nachomcapella/3D-printed-elbow-and-forearm-orthosis/documentacion/images/modelo-3d-6-2.JPG

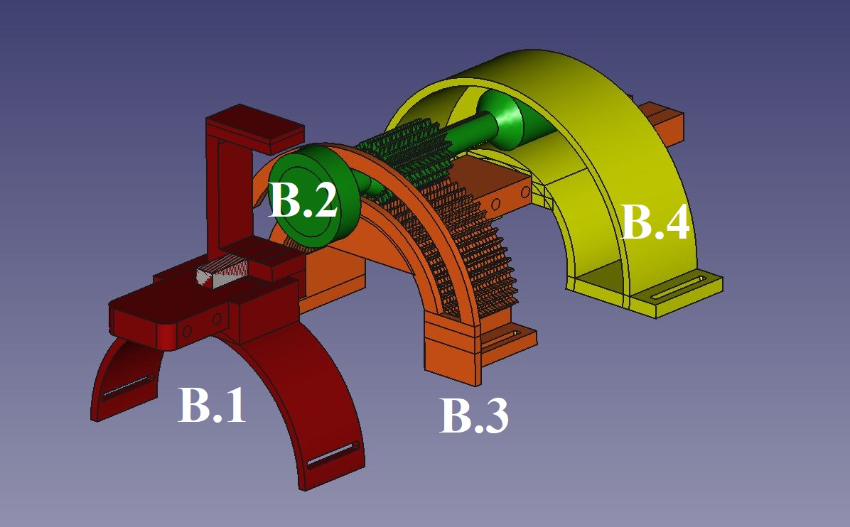
documentacion/images/modelo-3d-6-2.JPG
