nachomcapella/3D-printed-elbow-and-forearm-orthosis/documentacion/documents/presentacion-proyectos-3.pptx

## Design, development and control of a robotic arm

Proyectos III – Ignacio Martínez Capella

## Index

- Introduction
- 3D design
- Electronic components
- Results
- Conclusions

## Introduction - Orthoses

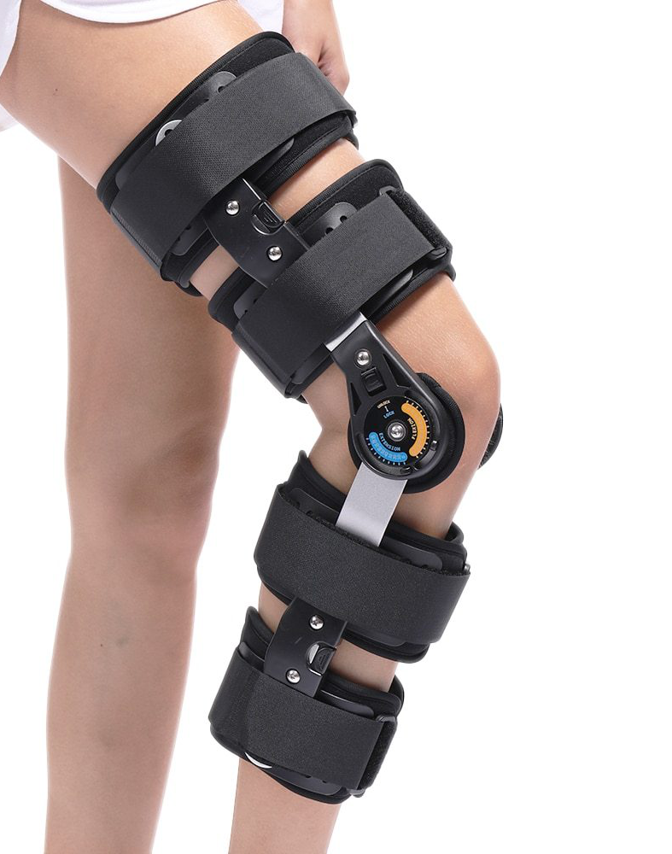
[picture p8: figure]

- What is an orthosis?
  - A medical device used to modify the functional and structural characteristics of the neuromuscular and skeletal system of the patient.
- Four types:
  - Supportive
  - Dynamic
  - Corrective
  - Protective
- Increasing demand
- 3D printers

## Introduction – Our model

- Based on a previous orthosis developed in the master’s degree
- 3D printed
- Flexion/extension of the arm
- New movements: pronation/supination of the forearm

## 3D design

- FreeCAD
- Witbox 3D printer, PLA filaments
- Two main pieces:
  - A: arm
  - B: forearm

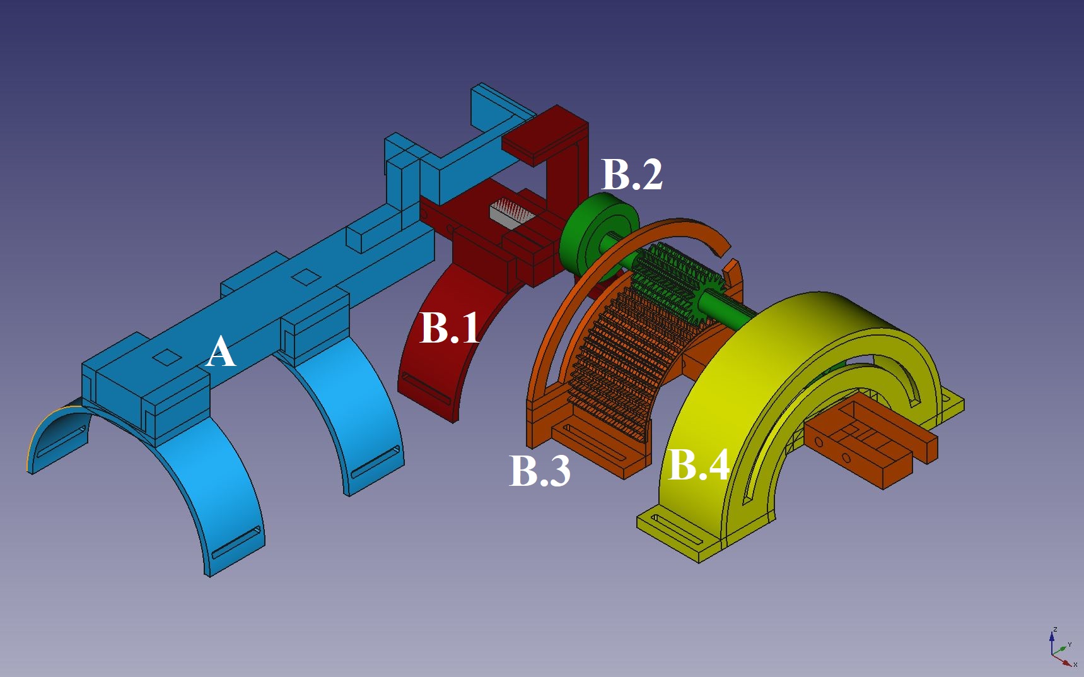
[picture p9: figure]

## 3D design

- FreeCAD
- Witbox 3D printer, PLA filaments
- Two main pieces:
  - A: arm
  - B: forearm


## Electronic components

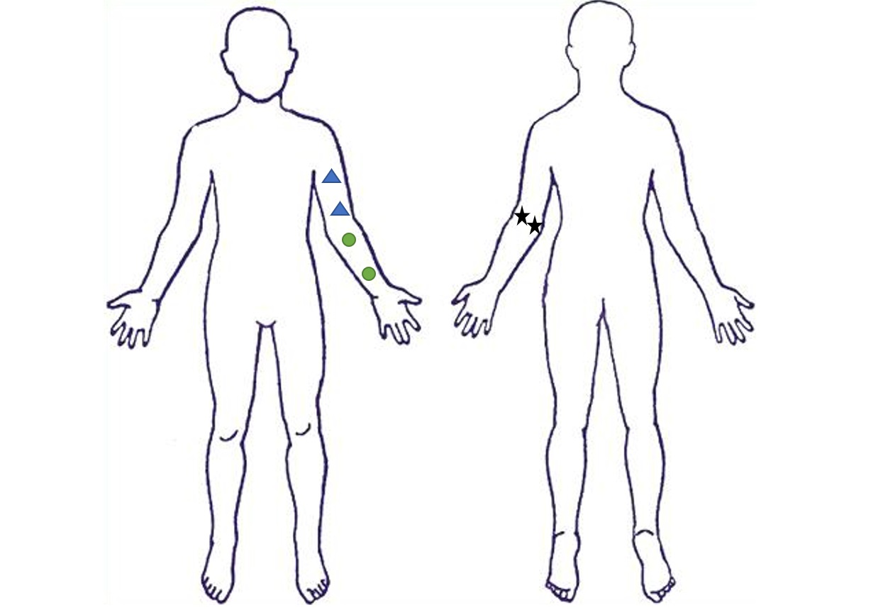
[picture p10: figure]

- A: EMG audio Jack
- B: Instrumentation amplifier
- C: Arduino Micro
- D: RG gain resistor
  - G=(5∗10^4)/(R_G)+1
- E: Servomotor

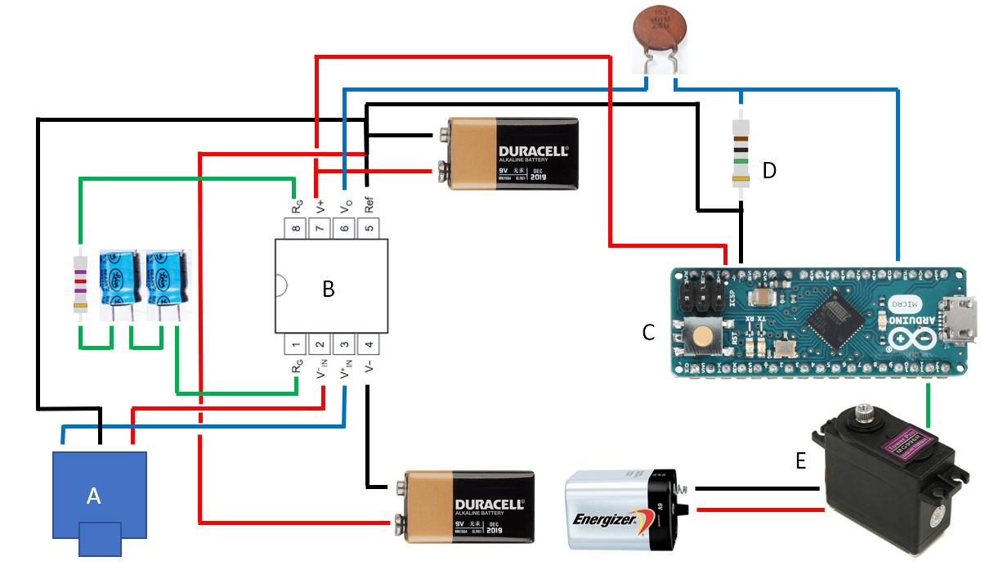
[picture p11: figure]

## Electronic components

- Voluntary contraction: Intended contraction of a muscle group
- Involuntary contraction: Passive contraction of a muscle group when another one is voluntarily contracted
  - Forearm: 5 voluntary + 5 involuntary contractions
  - Biceps: 5 voluntary + 5 involuntary contractions

Signal | Top 25 values mean
Voluntary forearm | 180.6
Involuntary forearm | 63.28
Voluntary biceps | 386.16
Involuntary biceps | 265

## Results

## Conclusions

- Objective achieved
- Future work
