nachomcapella/3D-printed-elbow-and-forearm-orthosis/documentacion/images/diagrama-emg-amplificador.pptx

## EMG Amplifier Diagram

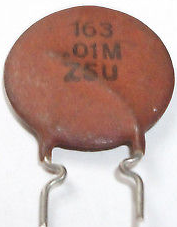
[picture p12: figure]
Resultado de imagen de bc z5u 103m
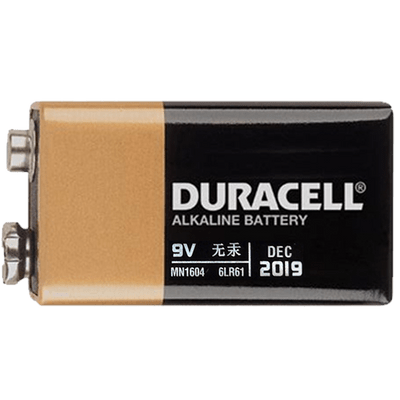
[picture p13: figure]
Resultado de imagen de 9v battery png

50K/R + 1

D

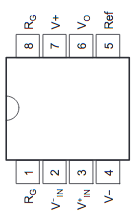
[picture p14: figure]
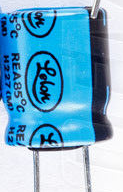
[picture p15: figure]
Resultado de imagen de rea85 35V

B

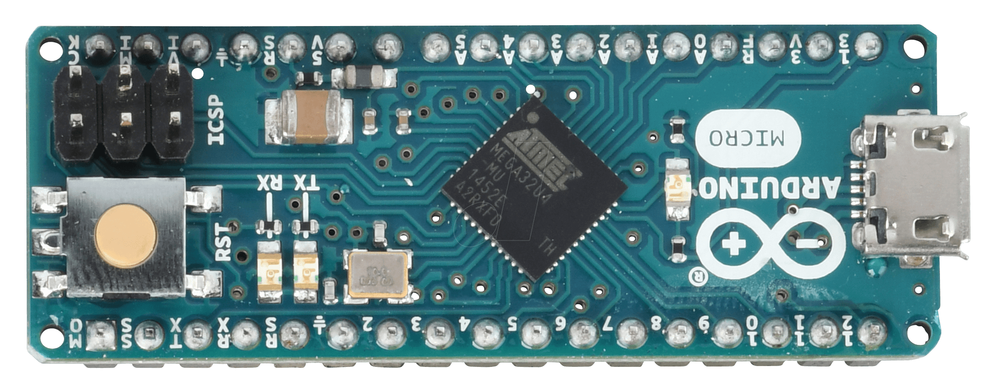
[picture p16: figure]
Resultado de imagen de arduino micro

C

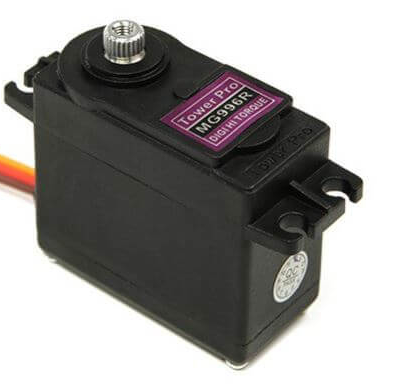
[picture p17: figure]

A

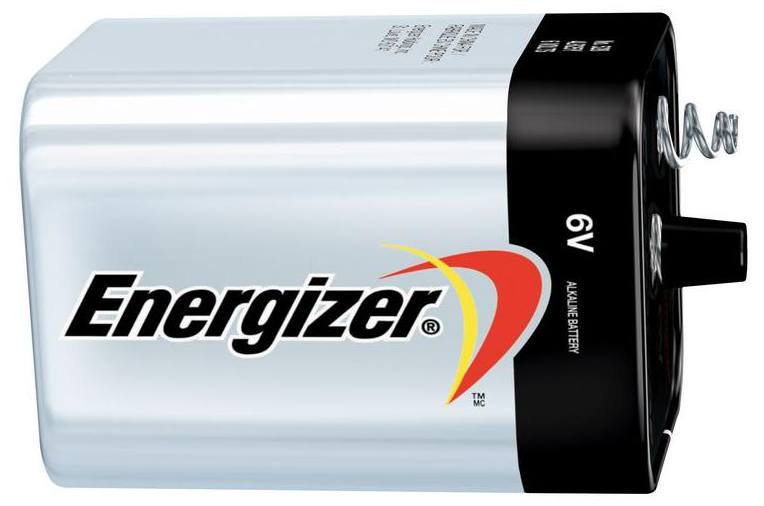
[picture p18: figure]

E
