nachomcapella/3D-printed-elbow-and-forearm-orthosis/documentacion/images/modelo-3d-5.JPG

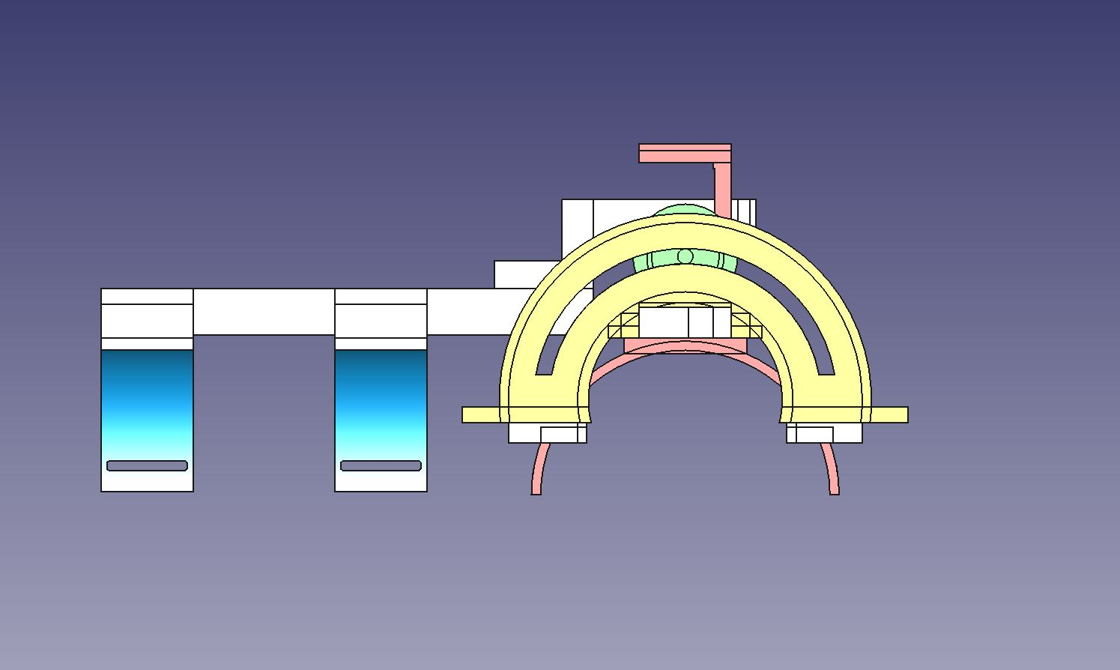
documentacion/images/modelo-3d-5.JPG
