nachomcapella/3D-printed-elbow-and-forearm-orthosis/documentacion/images/orthosis-final.JPG

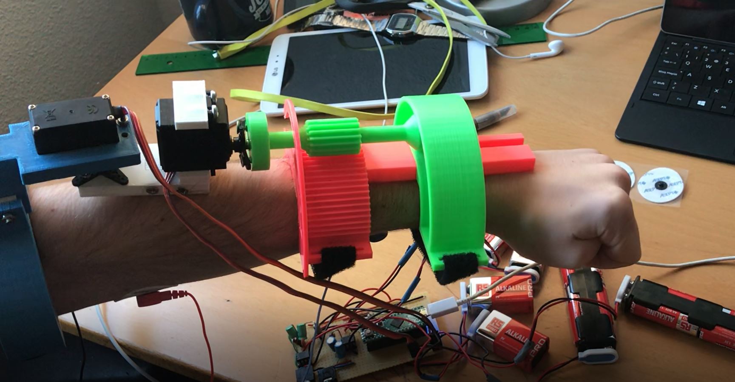
documentacion/images/orthosis-final.JPG
