nachomcapella/3D-printed-elbow-and-forearm-orthosis/3D/pieza-principal-v3.stl

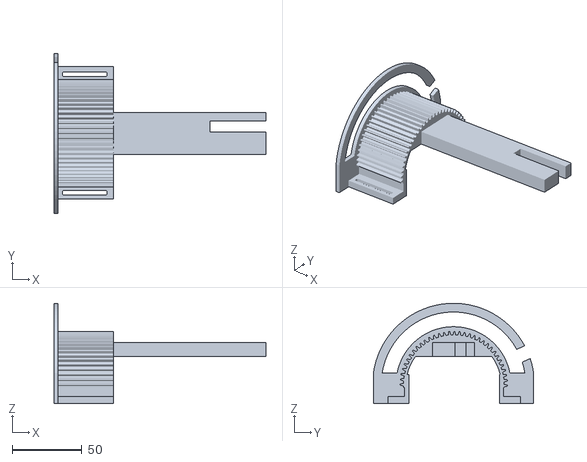
[picture p31: CAD file, 2019-01-29]
3D/pieza-principal-v3.stl
152.0 x 115.0 x 72.0
