nachomcapella/3D-printed-elbow-and-forearm-orthosis/3D/contranclaje2-v1.stl

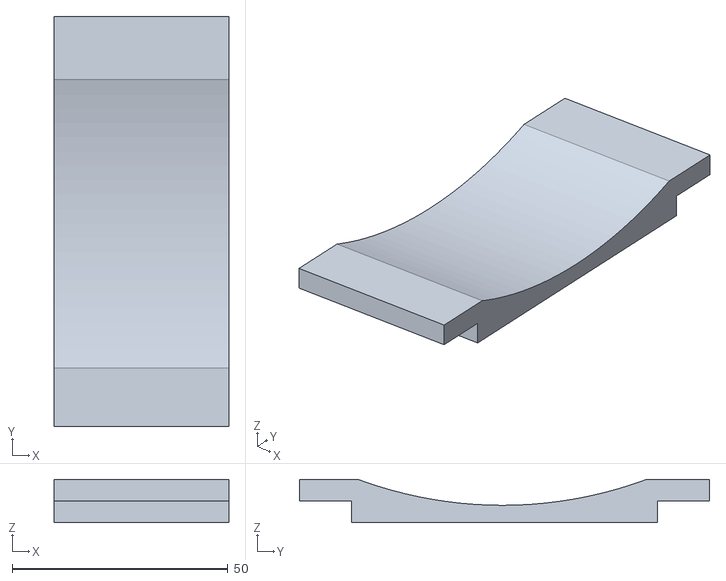
[picture p32: CAD file, 2019-01-29]
3D/contranclaje2-v1.stl
40.5 x 95.0 x 10.0
