nachomcapella/3D-printed-elbow-and-forearm-orthosis/3D/caja-electronica.FCStd

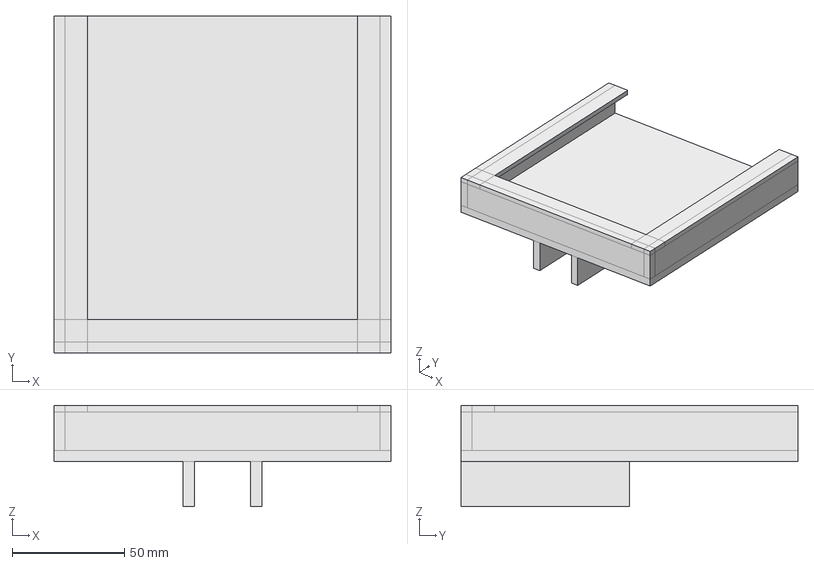
[picture p33: CAD file, 2019-01-29]
3D/caja-electronica.FCStd
150.0 x 150.0 x 45.0 mm
