nachomcapella/3D-printed-elbow-and-forearm-orthosis/3D/anclaje3-v3.stl

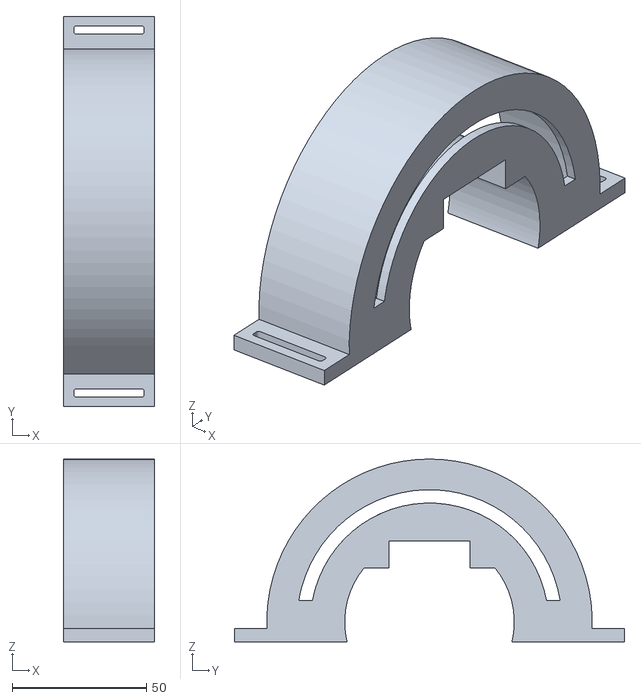
[picture p34: CAD file, 2019-01-29]
3D/anclaje3-v3.stl
34.0 x 145.0 x 68.0
