nachomcapella/3D-printed-elbow-and-forearm-orthosis/3D/contraanclaje3-v2.stl

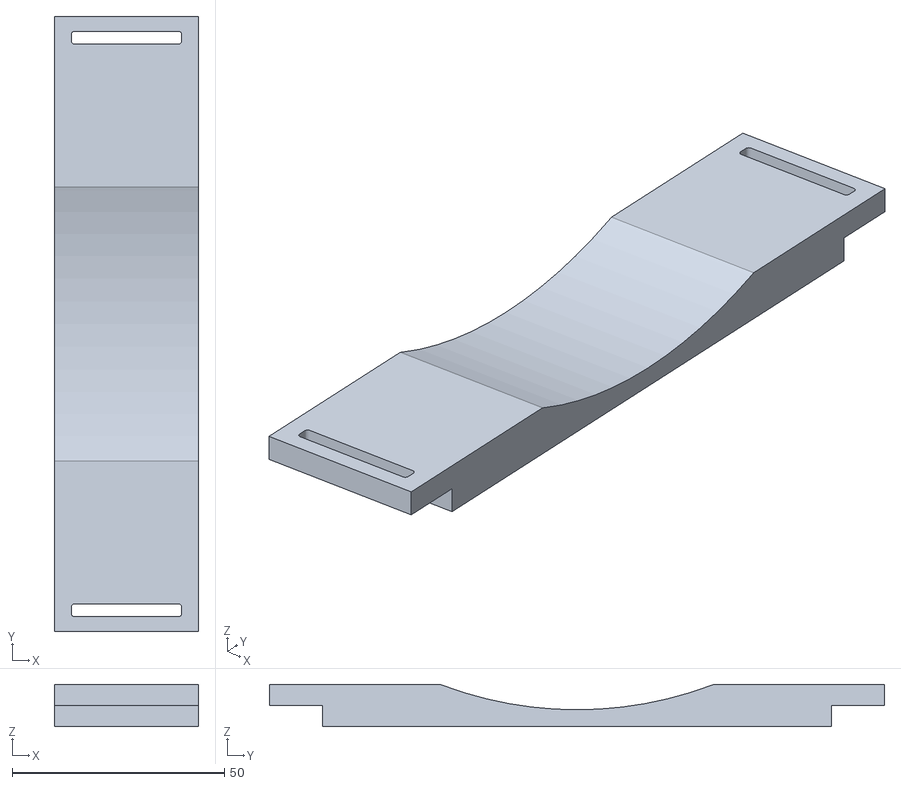
[picture p35: CAD file, 2019-01-29]
3D/contraanclaje3-v2.stl
34.0 x 145.0 x 10.0
