nachomcapella/3D-printed-elbow-and-forearm-orthosis/3D/continuacion-sistema1-v1.stl

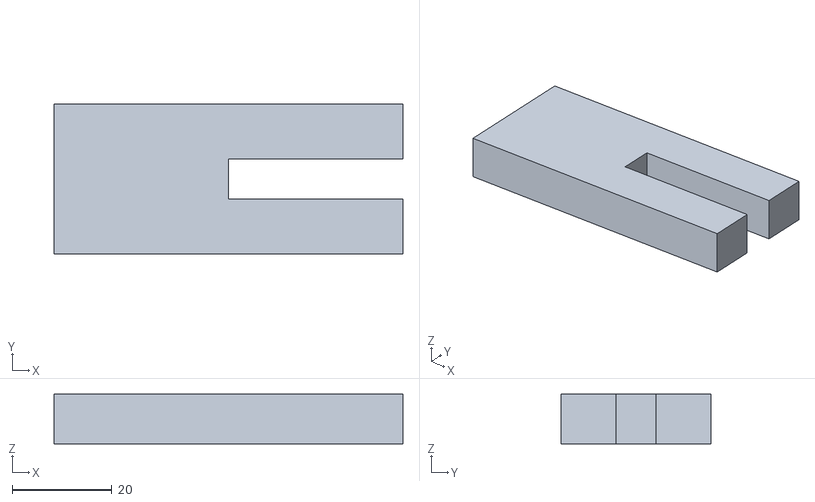
[picture p36: CAD file, 2019-01-29]
3D/continuacion-sistema1-v1.stl
70.0 x 30.0 x 10.0
