nachomcapella/3D-printed-elbow-and-forearm-orthosis/3D/soporte-motor2-v2.stl

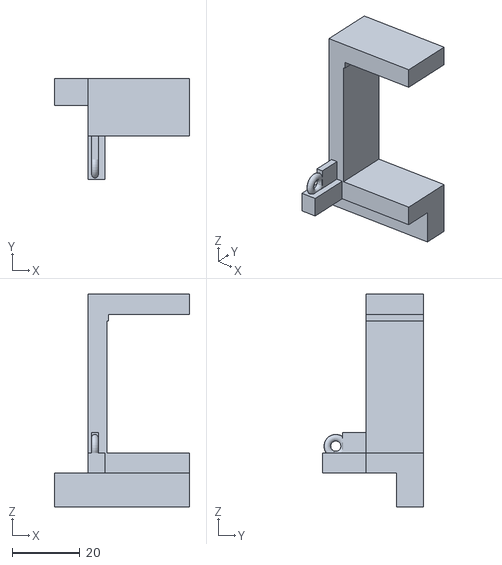
[picture p37: CAD file, 2019-01-29]
3D/soporte-motor2-v2.stl
40.0 x 30.0 x 63.0
