nachomcapella/3D-printed-elbow-and-forearm-orthosis/3D/correa-v1.stl

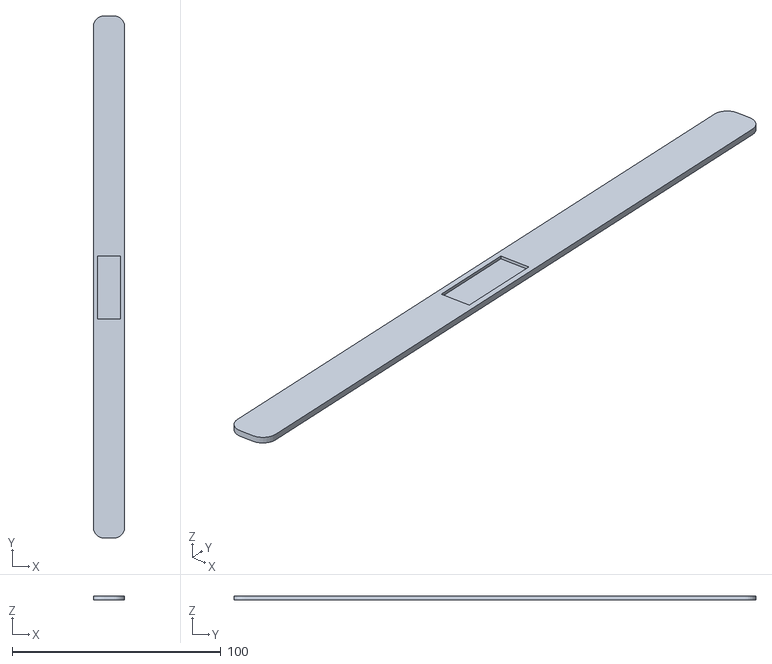
[picture p38: CAD file, 2019-01-29]
3D/correa-v1.stl
15.0 x 250.0 x 2.00
