nachomcapella/3D-printed-elbow-and-forearm-orthosis/3D/soporte_motor_v3.stl

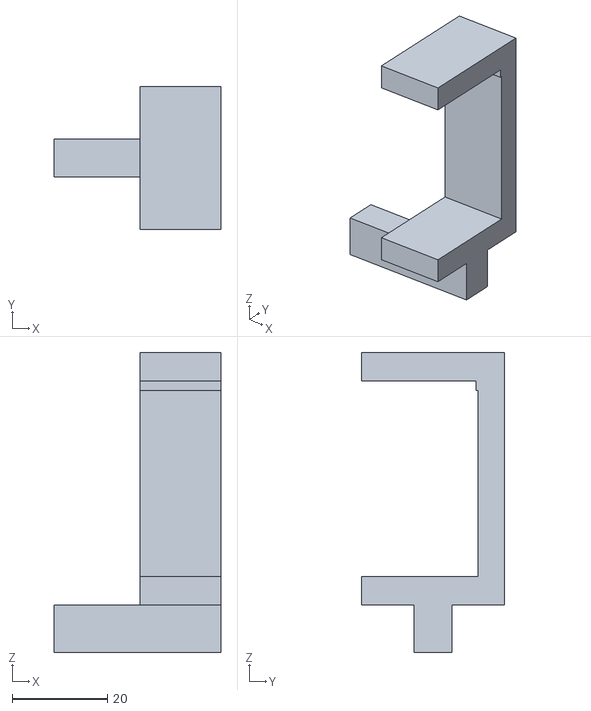
[picture p39: CAD file, 2019-01-29]
3D/soporte_motor_v3.stl
35.0 x 30.0 x 63.0
