nachomcapella/3D-printed-elbow-and-forearm-orthosis/3D/anclaje1-v2.stl

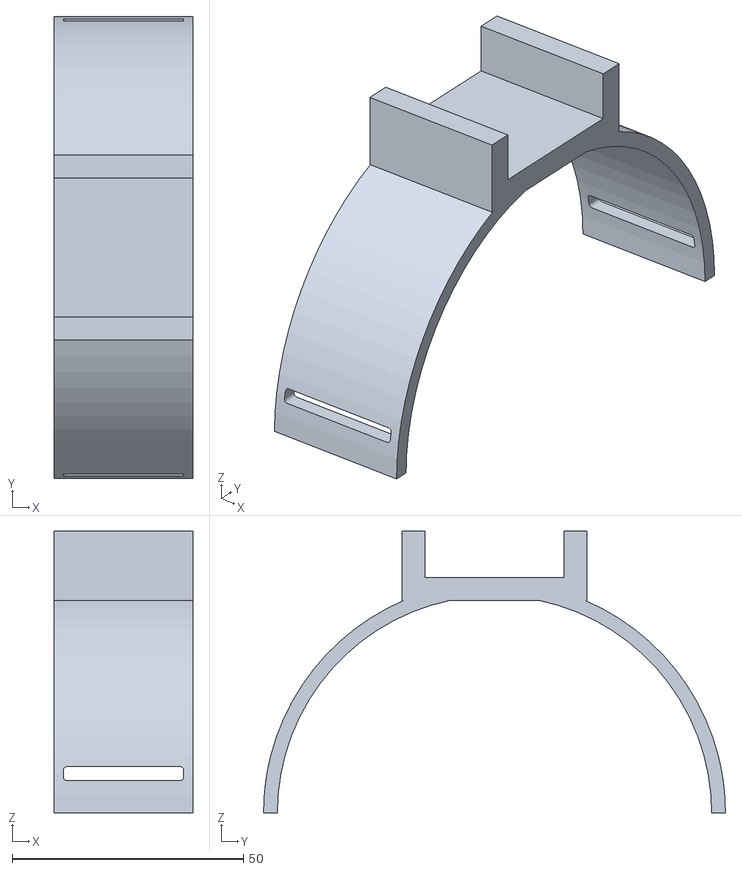
[picture p40: CAD file, 2019-01-29]
3D/anclaje1-v2.stl
30.0 x 100.0 x 61.0
