nachomcapella/3D-printed-elbow-and-forearm-orthosis/3D/engranaje-2-v2.stl

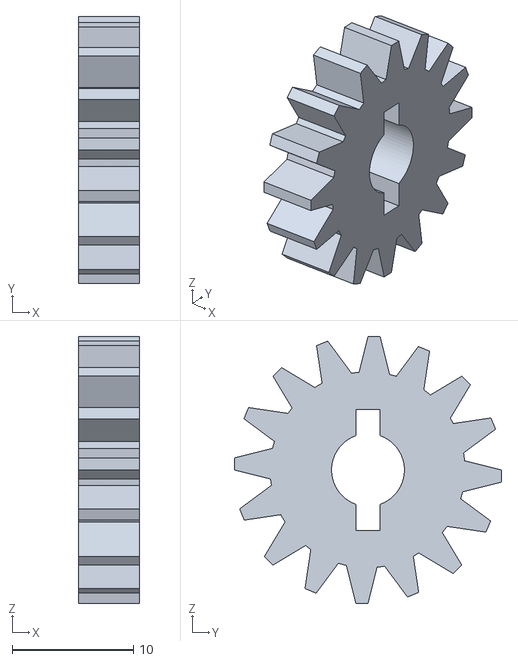
[picture p41: CAD file, 2019-01-29]
3D/engranaje-2-v2.stl
5.00 x 22.0 x 22.0
