nachomcapella/3D-printed-elbow-and-forearm-orthosis/3D/rotor-v3.stl

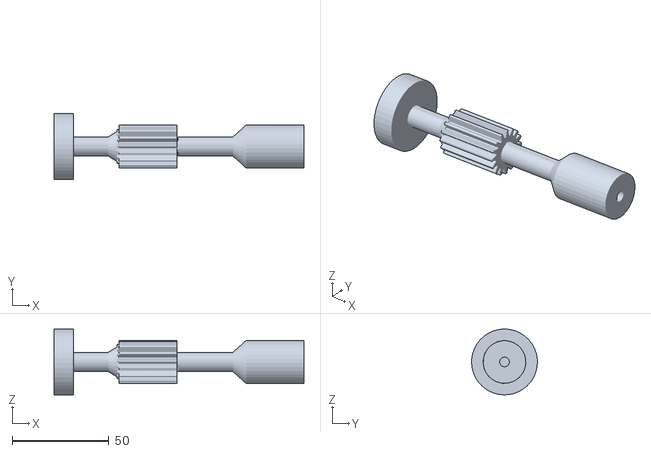
[picture p42: CAD file, 2019-01-29]
3D/rotor-v3.stl
129.0 x 34.0 x 34.0
