nachomcapella/3D-printed-elbow-and-forearm-orthosis/3D/contraanclaje2-v2.stl

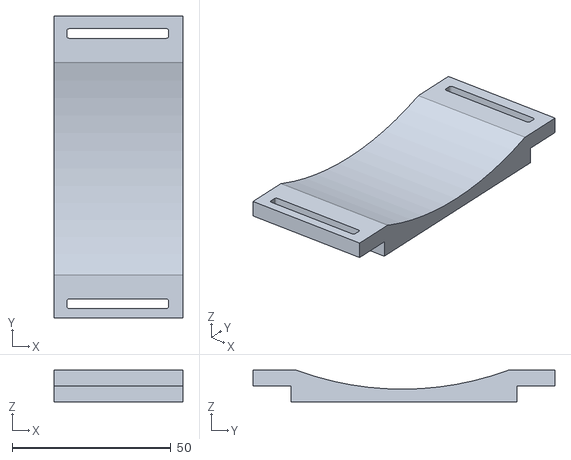
[picture p43: CAD file, 2019-01-29]
3D/contraanclaje2-v2.stl
40.5 x 95.0 x 10.0
