nachomcapella/3D-printed-elbow-and-forearm-orthosis/3D/engranaje-1-v3.stl

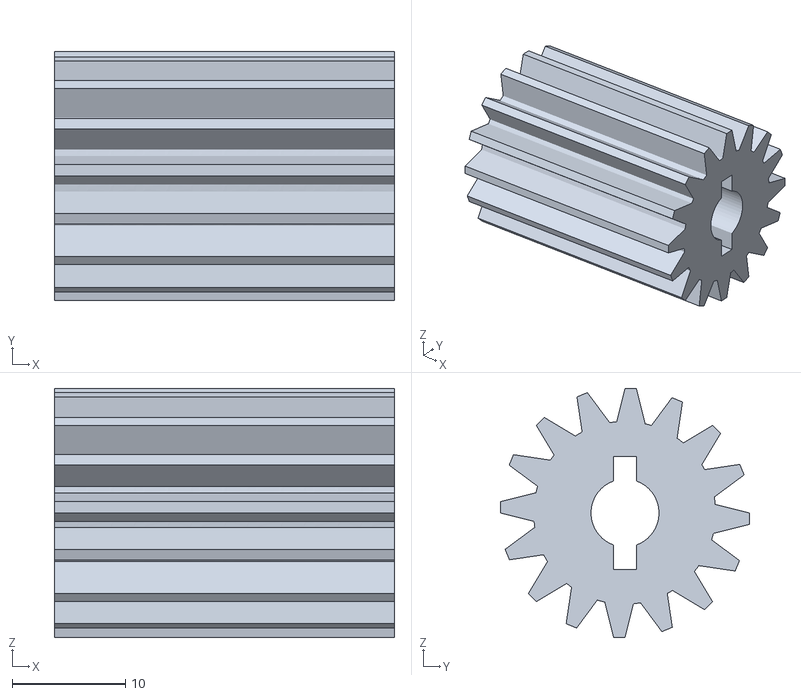
[picture p44: CAD file, 2019-01-29]
3D/engranaje-1-v3.stl
30.0 x 22.0 x 22.0
