nachomcapella/3D-printed-elbow-and-forearm-orthosis/3D/enganche-cuerda-v1.stl

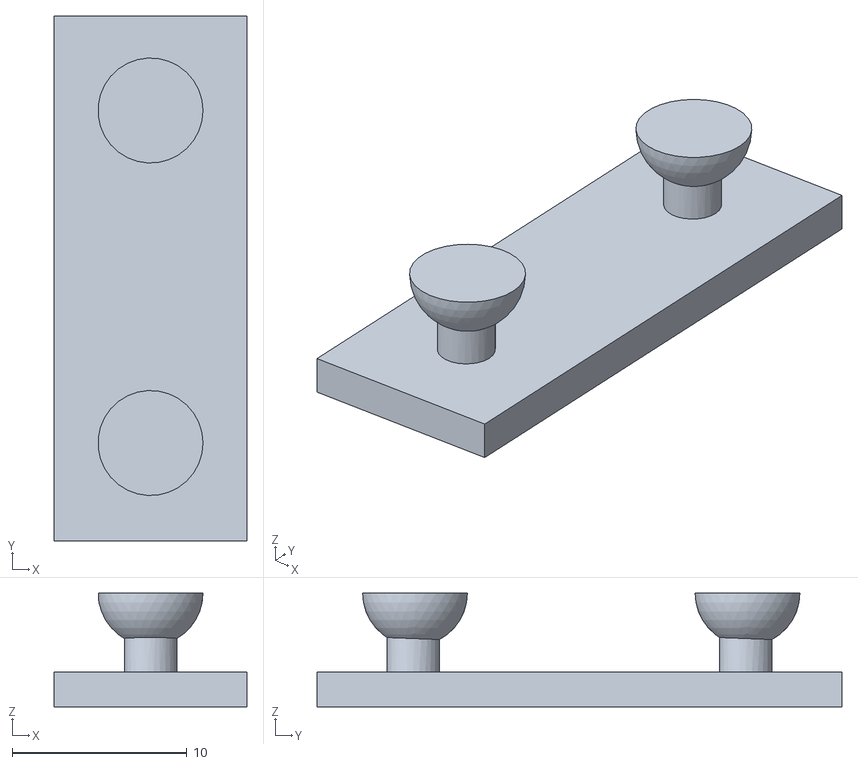
[picture p45: CAD file, 2019-01-29]
3D/enganche-cuerda-v1.stl
11.0 x 30.0 x 6.50
