nachomcapella/3D-printed-elbow-and-forearm-orthosis/3D/cilindro-rotor-v1.stl

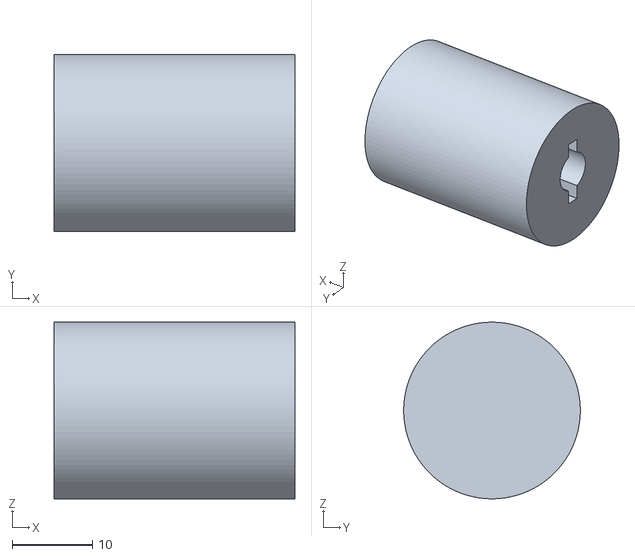
[picture p46: CAD file, 2019-01-29]
3D/cilindro-rotor-v1.stl
30.0 x 22.0 x 22.0
