nachomcapella/3D-printed-elbow-and-forearm-orthosis/(list of files, cad)

Other CAD files:
3D/contranclaje3-v1.stl
3D/soporte_rotor_v1.stl
3D/anclaje1_v1.stl
3D/anclaje3-v2.stl
3D/caja-electronica.stl
3D/engranaje-1-v2.stl
3D/pieza-principal-v1.stl
3D/pieza-principal-v2.stl
3D/rotor-v1.stl
3D/rotor-v2.stl
3D/soporte_motor_v1.stl
3D/soporte_motor_v2.stl
